afdaniele/calibrator-9000/pictures/3d_model_bottom.png

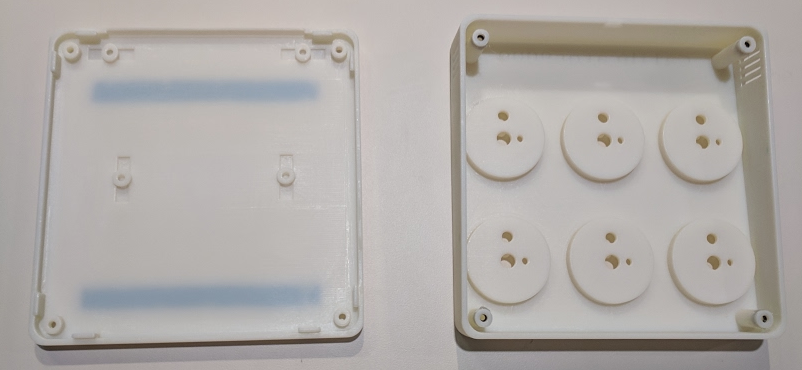
pictures/3d_model_bottom.png
