afdaniele/calibrator-9000/pictures/3d_model_top.png

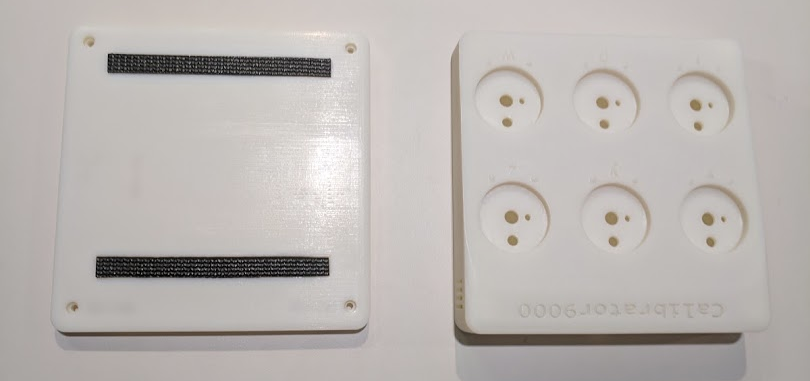
pictures/3d_model_top.png
