afdaniele/calibrator-9000/renderings/18june2018.png

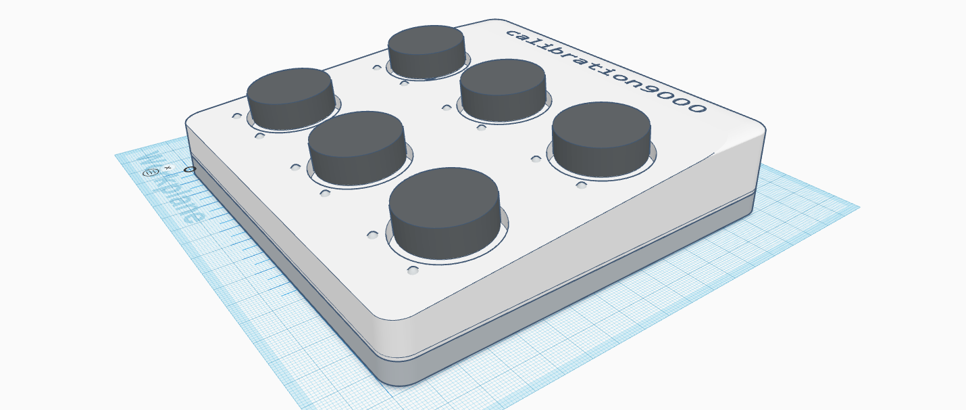
renderings/18june2018.png
