afdaniele/calibrator-9000/renderings/21june2018.png

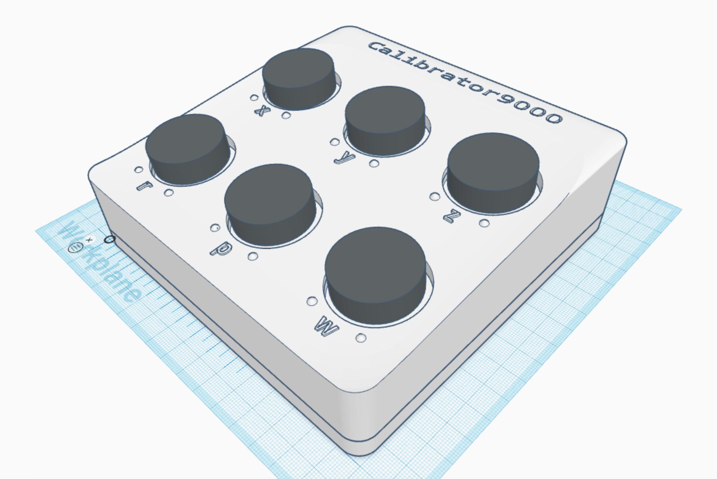
renderings/21june2018.png
