afdaniele/calibrator-9000/(threads)

Thread 1 (2018-07-14):

CALIBRATING mode when a fraction of knobs is already calibrated

afdaniele, 2018-07-14:
When the device is initialized, the device loads the calibration file but it does not check which knobs are calibrated and which ones are not. Enabling x, and y with only y calibrated sends the device in INITIALIZING mode. It should go in CALIBRATING mode with x=UNCALIBRATED and y=UNITIALIZED.

afdaniele, 2018-07-16:
Fixed.
Now the device does not calibrates after initialization but before, so all the knobs are calibrated. The calibration file cannot have uncalibrated knobs.

Closed 2018-07-16.

Thread 2 (2018-07-14):

second call to `initialize()` sends the firmware in CALIBRATING mode

afdaniele, 2018-07-14:
The first time I call `initialize()` after plugging in the device, the device goes in INITILIZING mode, which is correct since the knobs are calibrated (even though the X is not, but that is not implemented yet, issue [1](https://github.com/afdaniele/calibrator-9000/issues/1)).

If I then call `initialize()` again without unplugging the device, the firmware goes in CALIBRATING mode. This should not happen.

Closed 2018-07-16.
