afdaniele/calibrator-9000/(commit log)

2018-06-19 firmware, read potentiometer via ADC on A5
2018-06-22 final rendering - 1st print
2018-06-23 knobs calibration; pwm led animation
2018-06-24 python drivers
2018-06-25 device initialization/reboot/shutdown via drivers implemented
    [basic_python.py, calibrator9000.ino]
2018-07-13 (permanent) calibration procedure implemented
2018-07-14 Python drivers first implementation. Bug solved in firmware with strings ending with space char being sent as 0
    [basic_python.py, calibrator9000.ino, calibrator9000.py, structures.py]
2018-07-16 fixed #2: double initialization resulting in CALIBRATING status
    [calibrator9000.ino]
2018-08-27 updated PWM pins, RST pin and voltage stabilization for calibration
2024-07-22 updated drivers to python3
